rhysyim/Electronic-Speed-Controller/README.md

A hardware implementation using comparators to compare BEMF of motor in /PCB/Triple Half Bridge Driver v4b2. The original implementatoin with current sensing amplifier in /PCB/Triple Half Bridge Driver v4a (footprints not in place yet).
