rhysyim/Electronic-Speed-Controller/Code/Thermistor_Instrumentation/README.md

# Address Pin Connections

| Pin | Connection |
| --- | --- |
| GND | 0x48 |
| VDD | 0x49 |
| SDA | 0x4A |
| SCL | 0x4B |
