rhysyim/Electronic-Speed-Controller/Oscilloscope Traces/Nov 2024/Separated Ground Plane.bmp

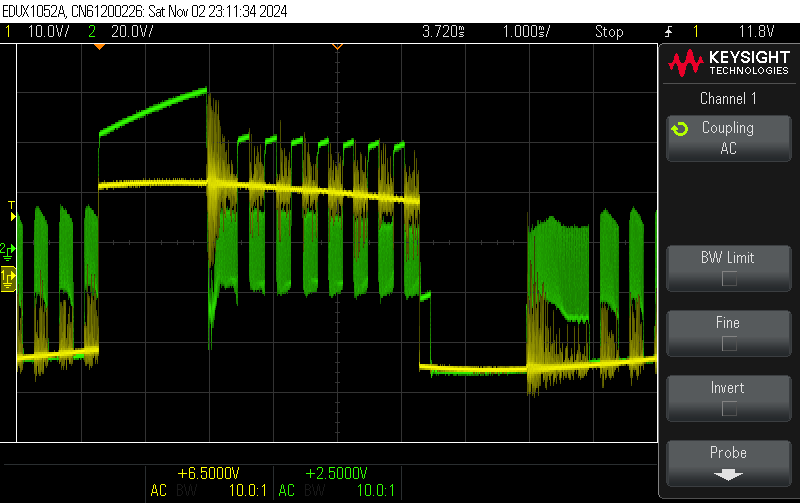
Oscilloscope Traces/Nov 2024/Separated Ground Plane.bmp
