rhysyim/Electronic-Speed-Controller/Oscilloscope Traces/Nov 2025/Gate driver output.png

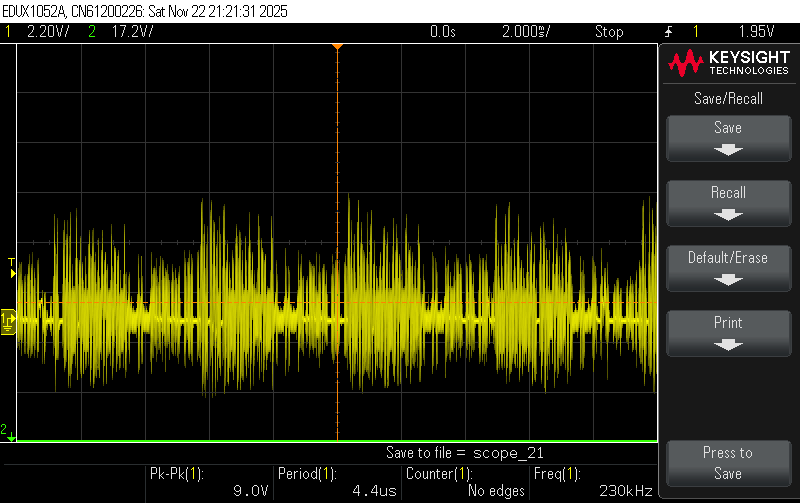
Oscilloscope Traces/Nov 2025/Gate driver output.png
