rhysyim/Electronic-Speed-Controller/Oscilloscope Traces/Nov 2025/Motor output (without turning).png

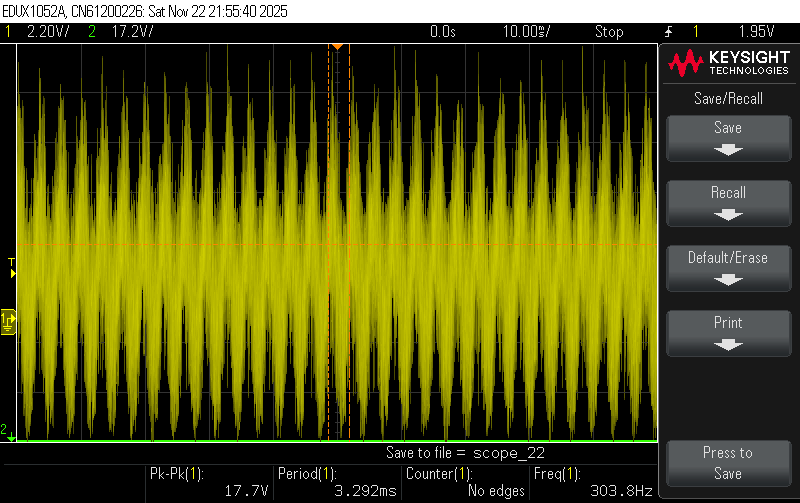
Oscilloscope Traces/Nov 2025/Motor output (without turning).png
