rhysyim/Electronic-Speed-Controller/Oscilloscope Traces/Nov 2025/PWM output from pi pico.png

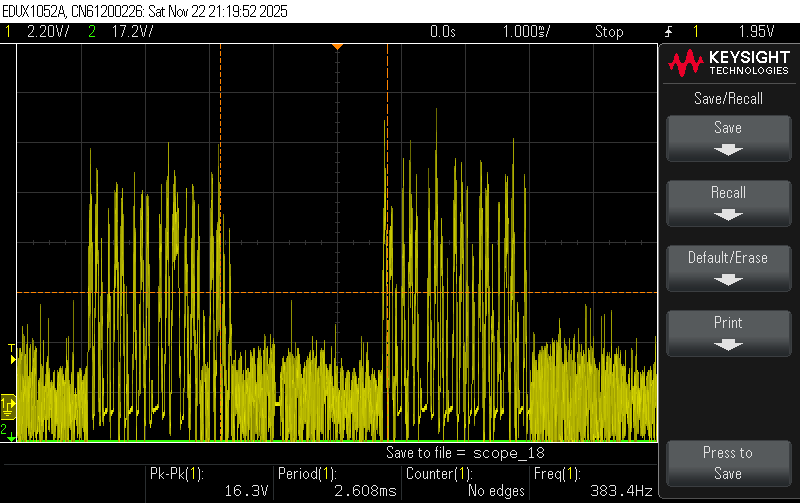
Oscilloscope Traces/Nov 2025/PWM output from pi pico.png
