rhysyim/Electronic-Speed-Controller/Bill of Materials Balancing Cube.docx

https://projecthub.arduino.cc/mircemk/arduino-3d-printed-self-balancing-cube-301832

MPU6050 for motion detection

Nidec 24h motors (?) or general BLDC motors
