rhysyim/Electronic-Speed-Controller/PCB/Triple Half Bridge Driver v4b3/PCB/ki-lime-pi-pico-1.0.0/models/RaspberryPi_Pico_Variations.FCStd

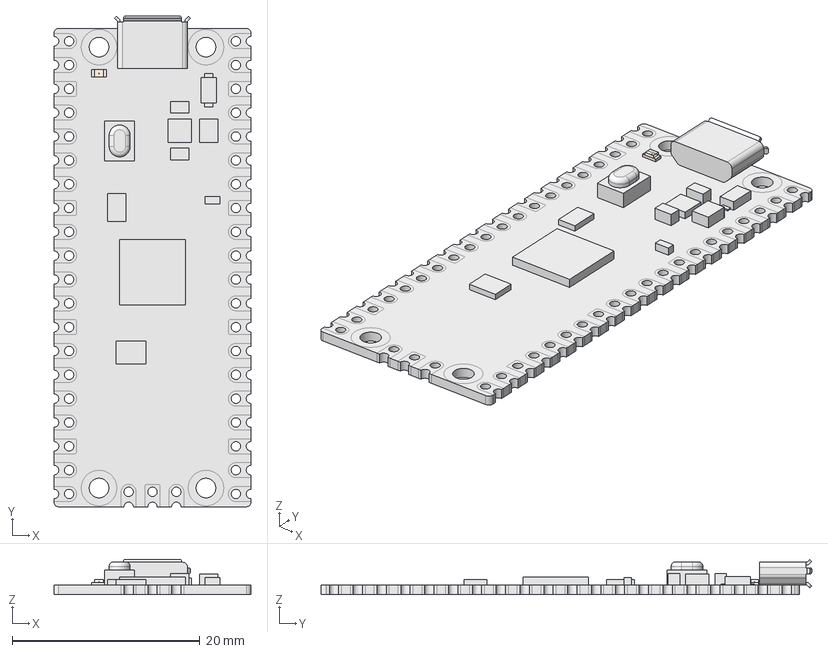
[picture p9: CAD file, 2026-09-11]
PCB/Triple Half Bridge Driver v4b3/PCB/ki-lime-pi-pico-1.0.0/models/RaspberryPi_Pico_Variations.FCStd
21.0 x 52.3 x 3.75 mm
Pico_Board
C1_47u
C2_47u
D1_MBR120VLSFT1G
D2_QSME-C194_Base
D2_QSME-C194_Phosphor
D2_QSME-C194_Lens
J1_690T505-x62-01x
L1_2u2
Q1_DMG1012T
SW1_TP-1221U-K9K5325
U1_RP2040
U2_RT6150B-33GQW
U3_W25Q16JVUXIQ
X1_X12M000000S096
