rhysyim/Electronic-Speed-Controller/Schematics_Annotated.pdf

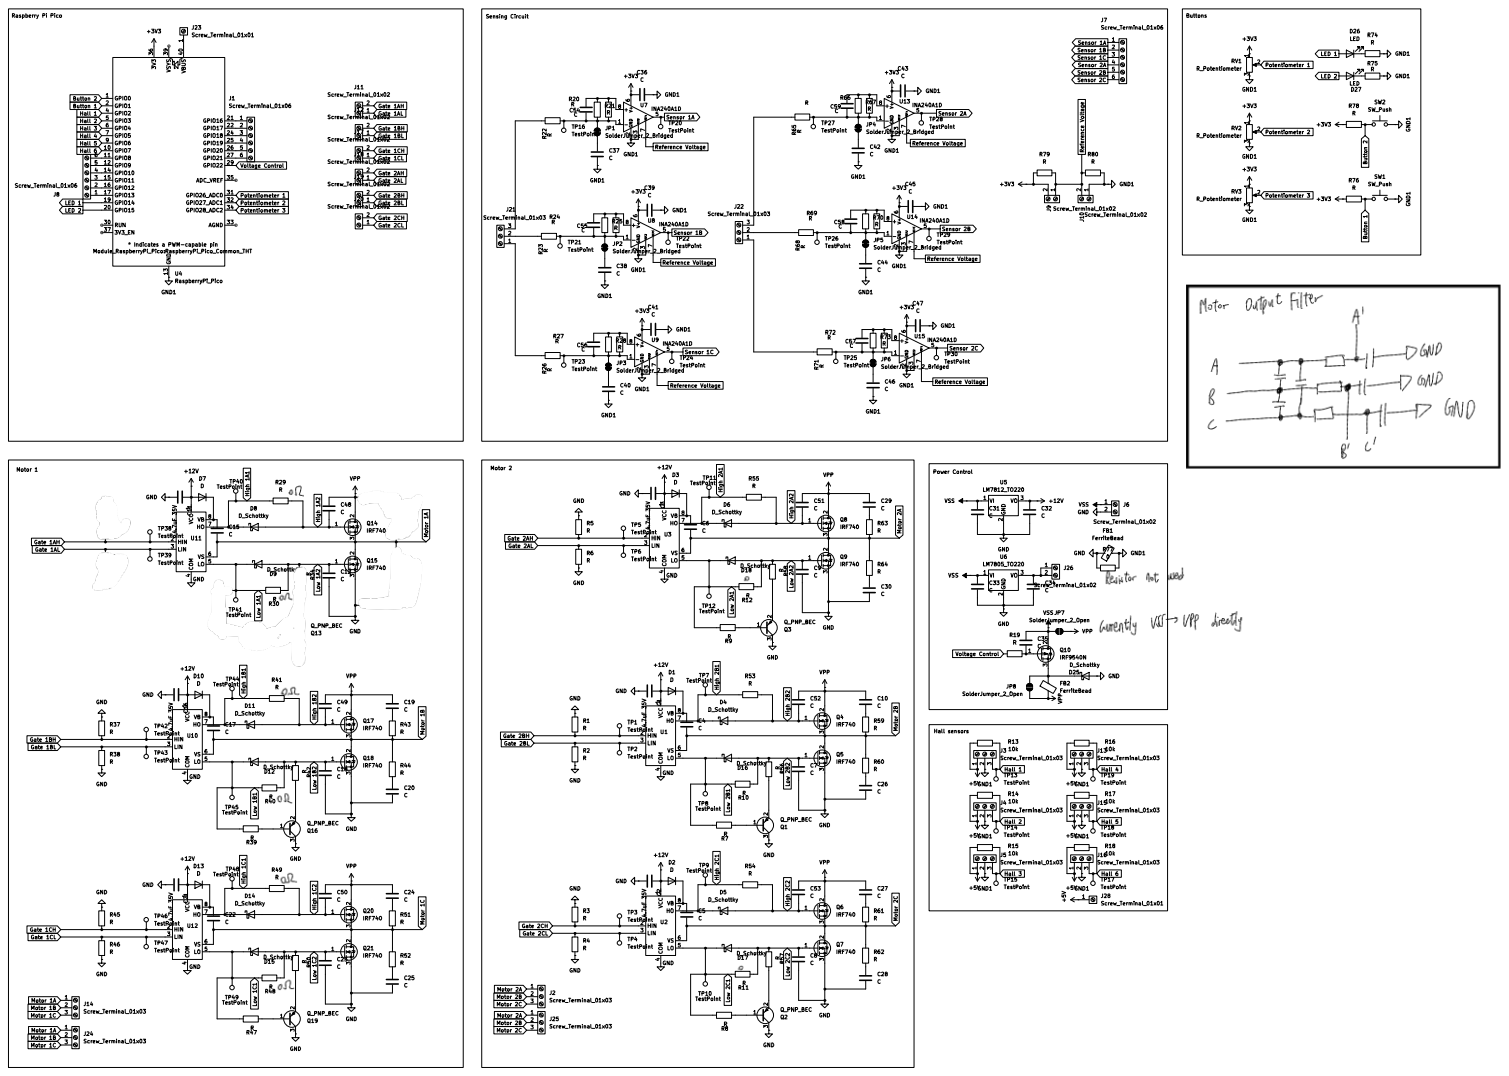
[picture p10: page 1]
