rhysyim/Electronic-Speed-Controller/Schematics.pdf

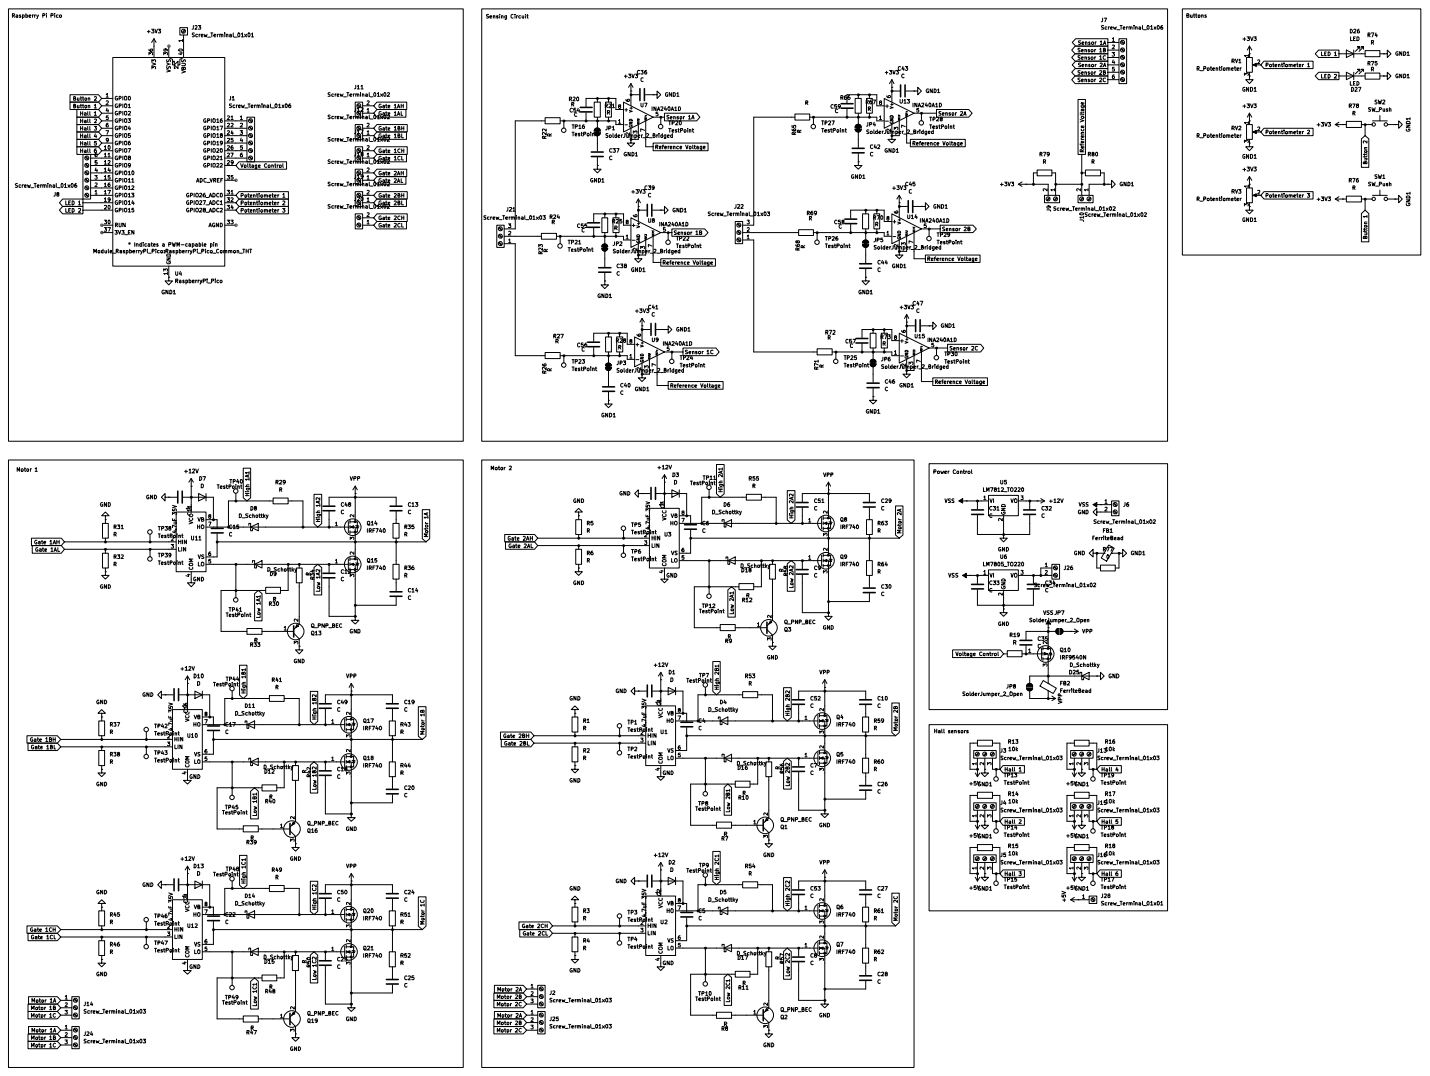
[picture p11: page 1]
