rhysyim/Electronic-Speed-Controller/PCB/Schematics Annotated.pdf

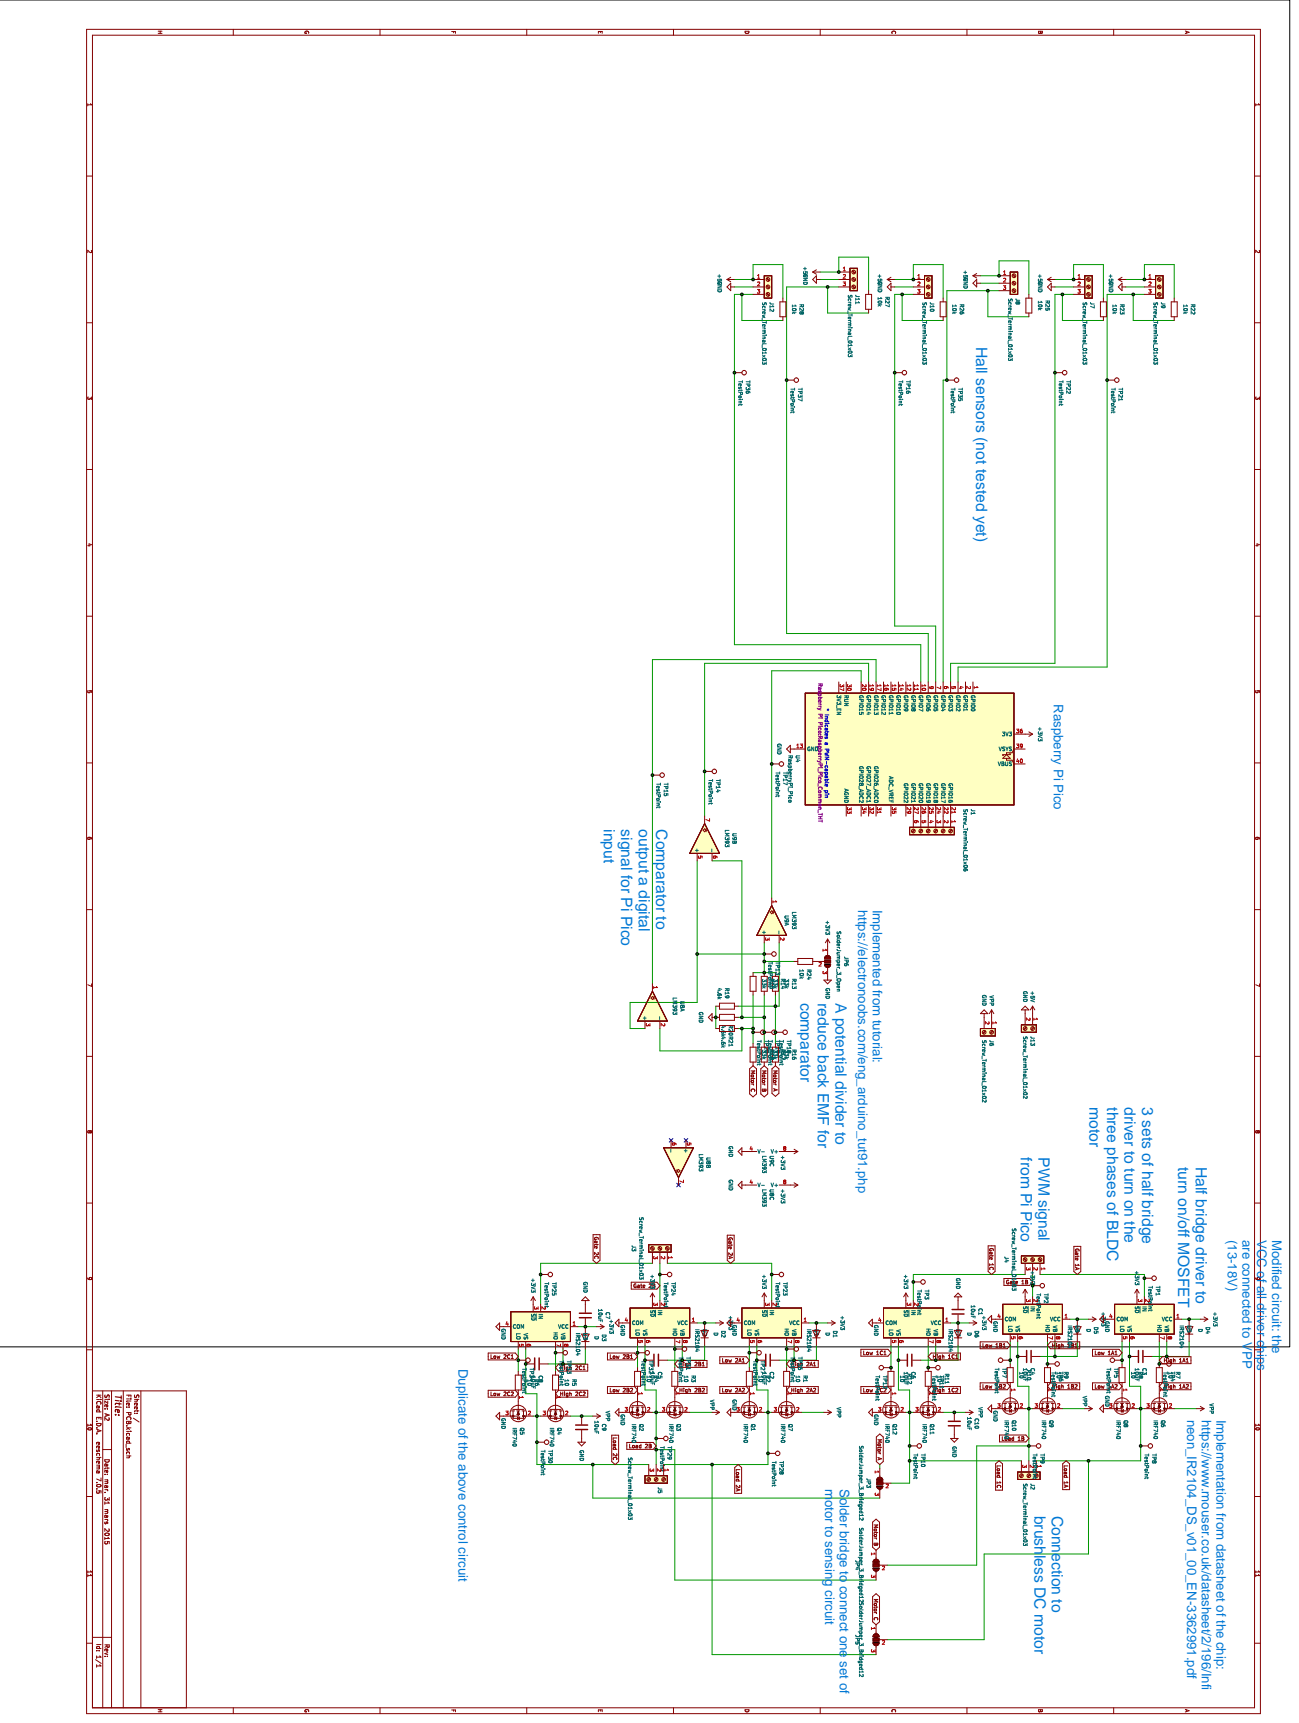
[picture p12: page 1]
