rhysyim/Electronic-Speed-Controller/PCB/Schematics.pdf

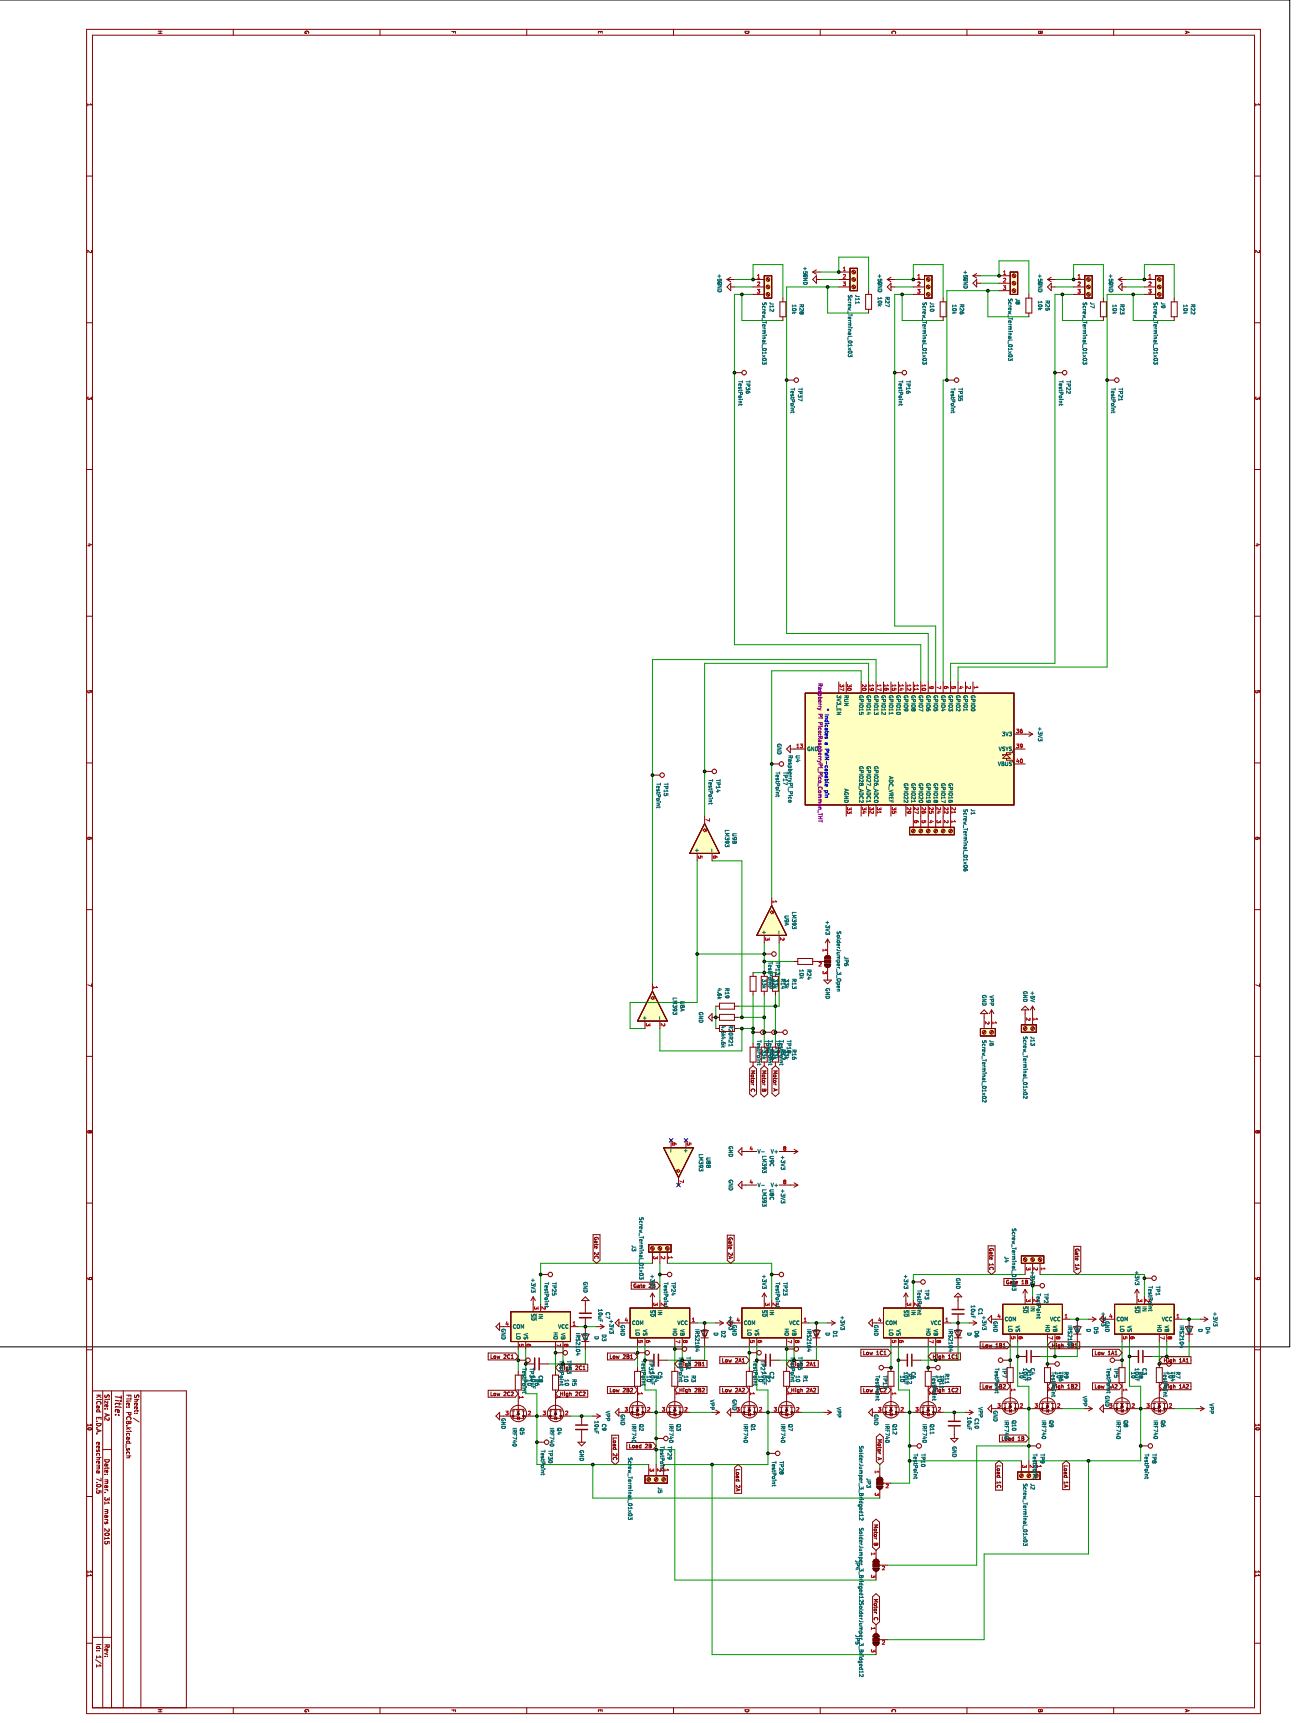
[picture p13: page 1]
