rhysyim/Electronic-Speed-Controller/PCB 2.pdf

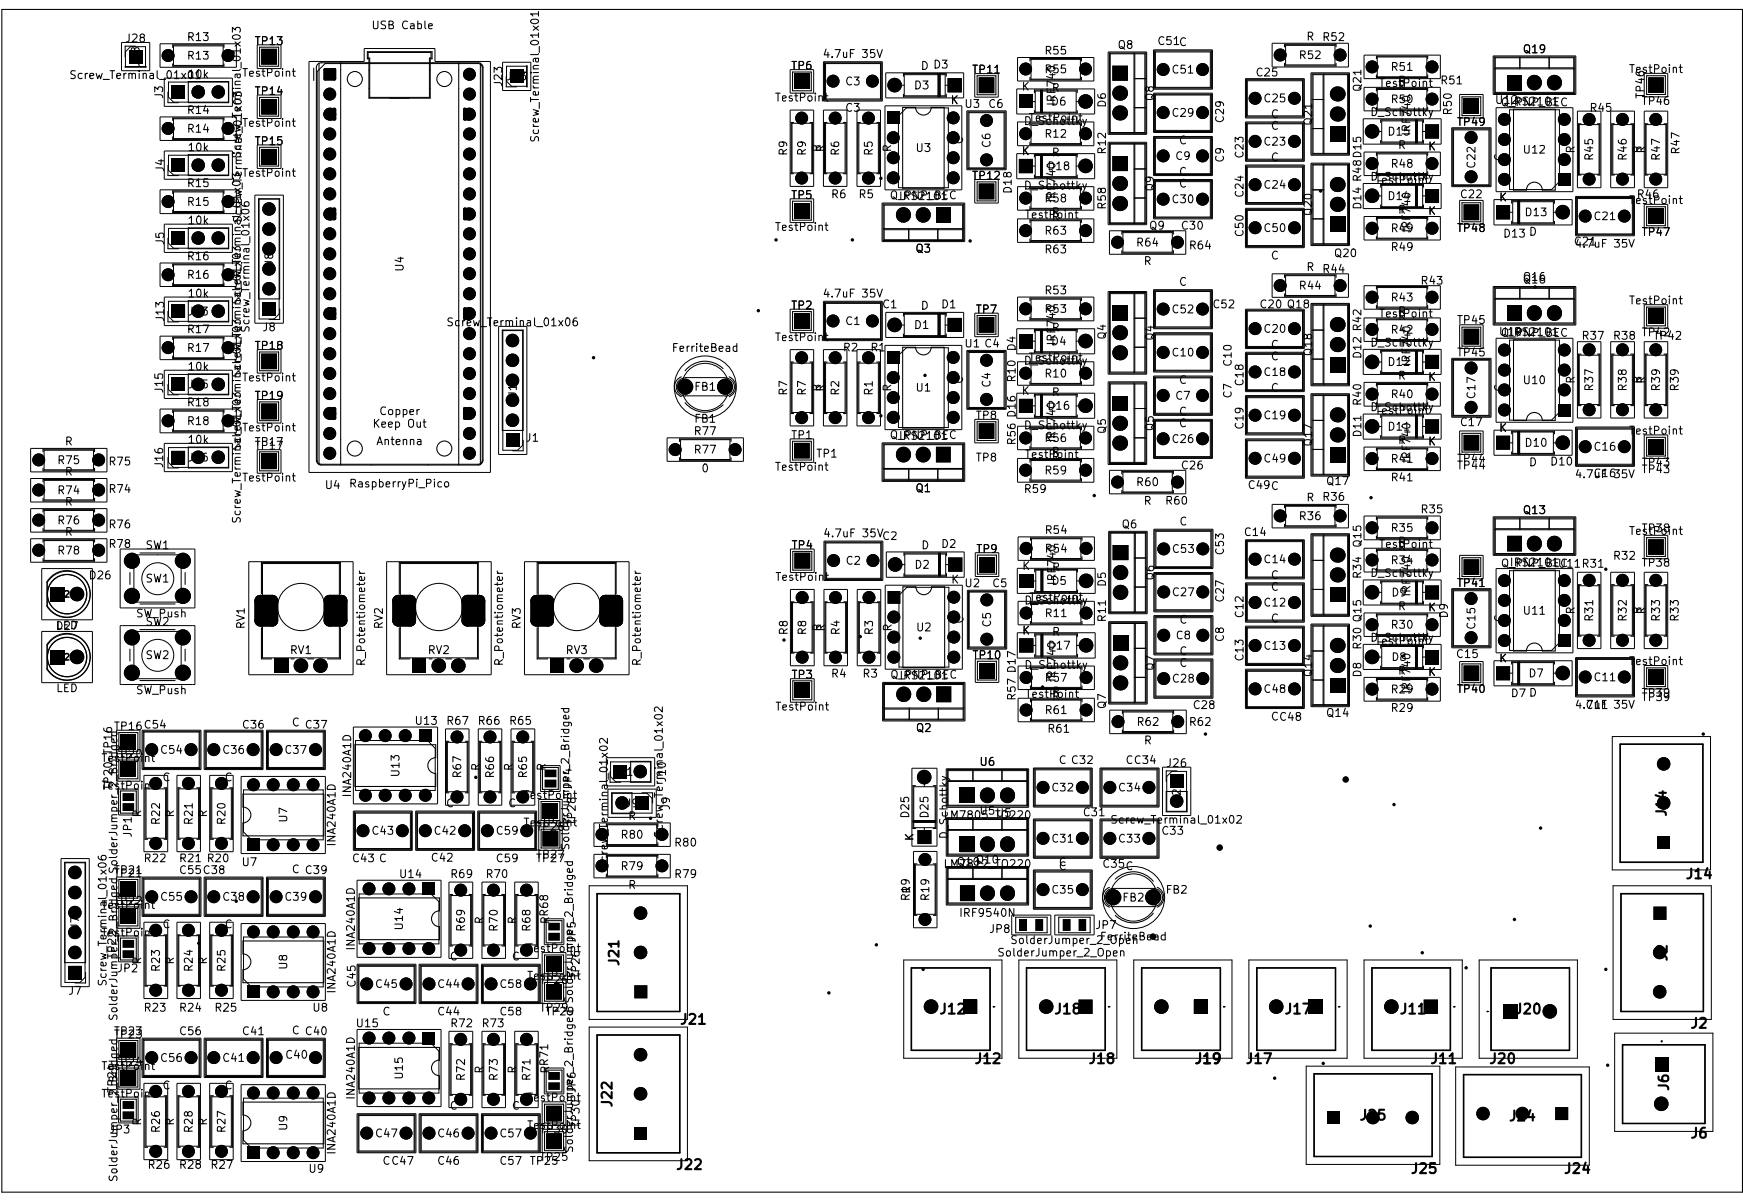
[picture p14: page 1]
