rhysyim/Electronic-Speed-Controller/(list of files, drawings)

Other design files:
PCB/Triple Half Bridge Driver v4b3/PCB.dsn
PCB/Triple Half Bridge Driver v4b4/PCB.dsn
