rhysyim/Electronic-Speed-Controller/PCB/Triple Half Bridge Driver v4b3/PCB/PCB.kicad_pcb

## KiCad design PCB/Triple Half Bridge Driver v4b3/PCB/PCB.kicad_pcb (2026-09-11)

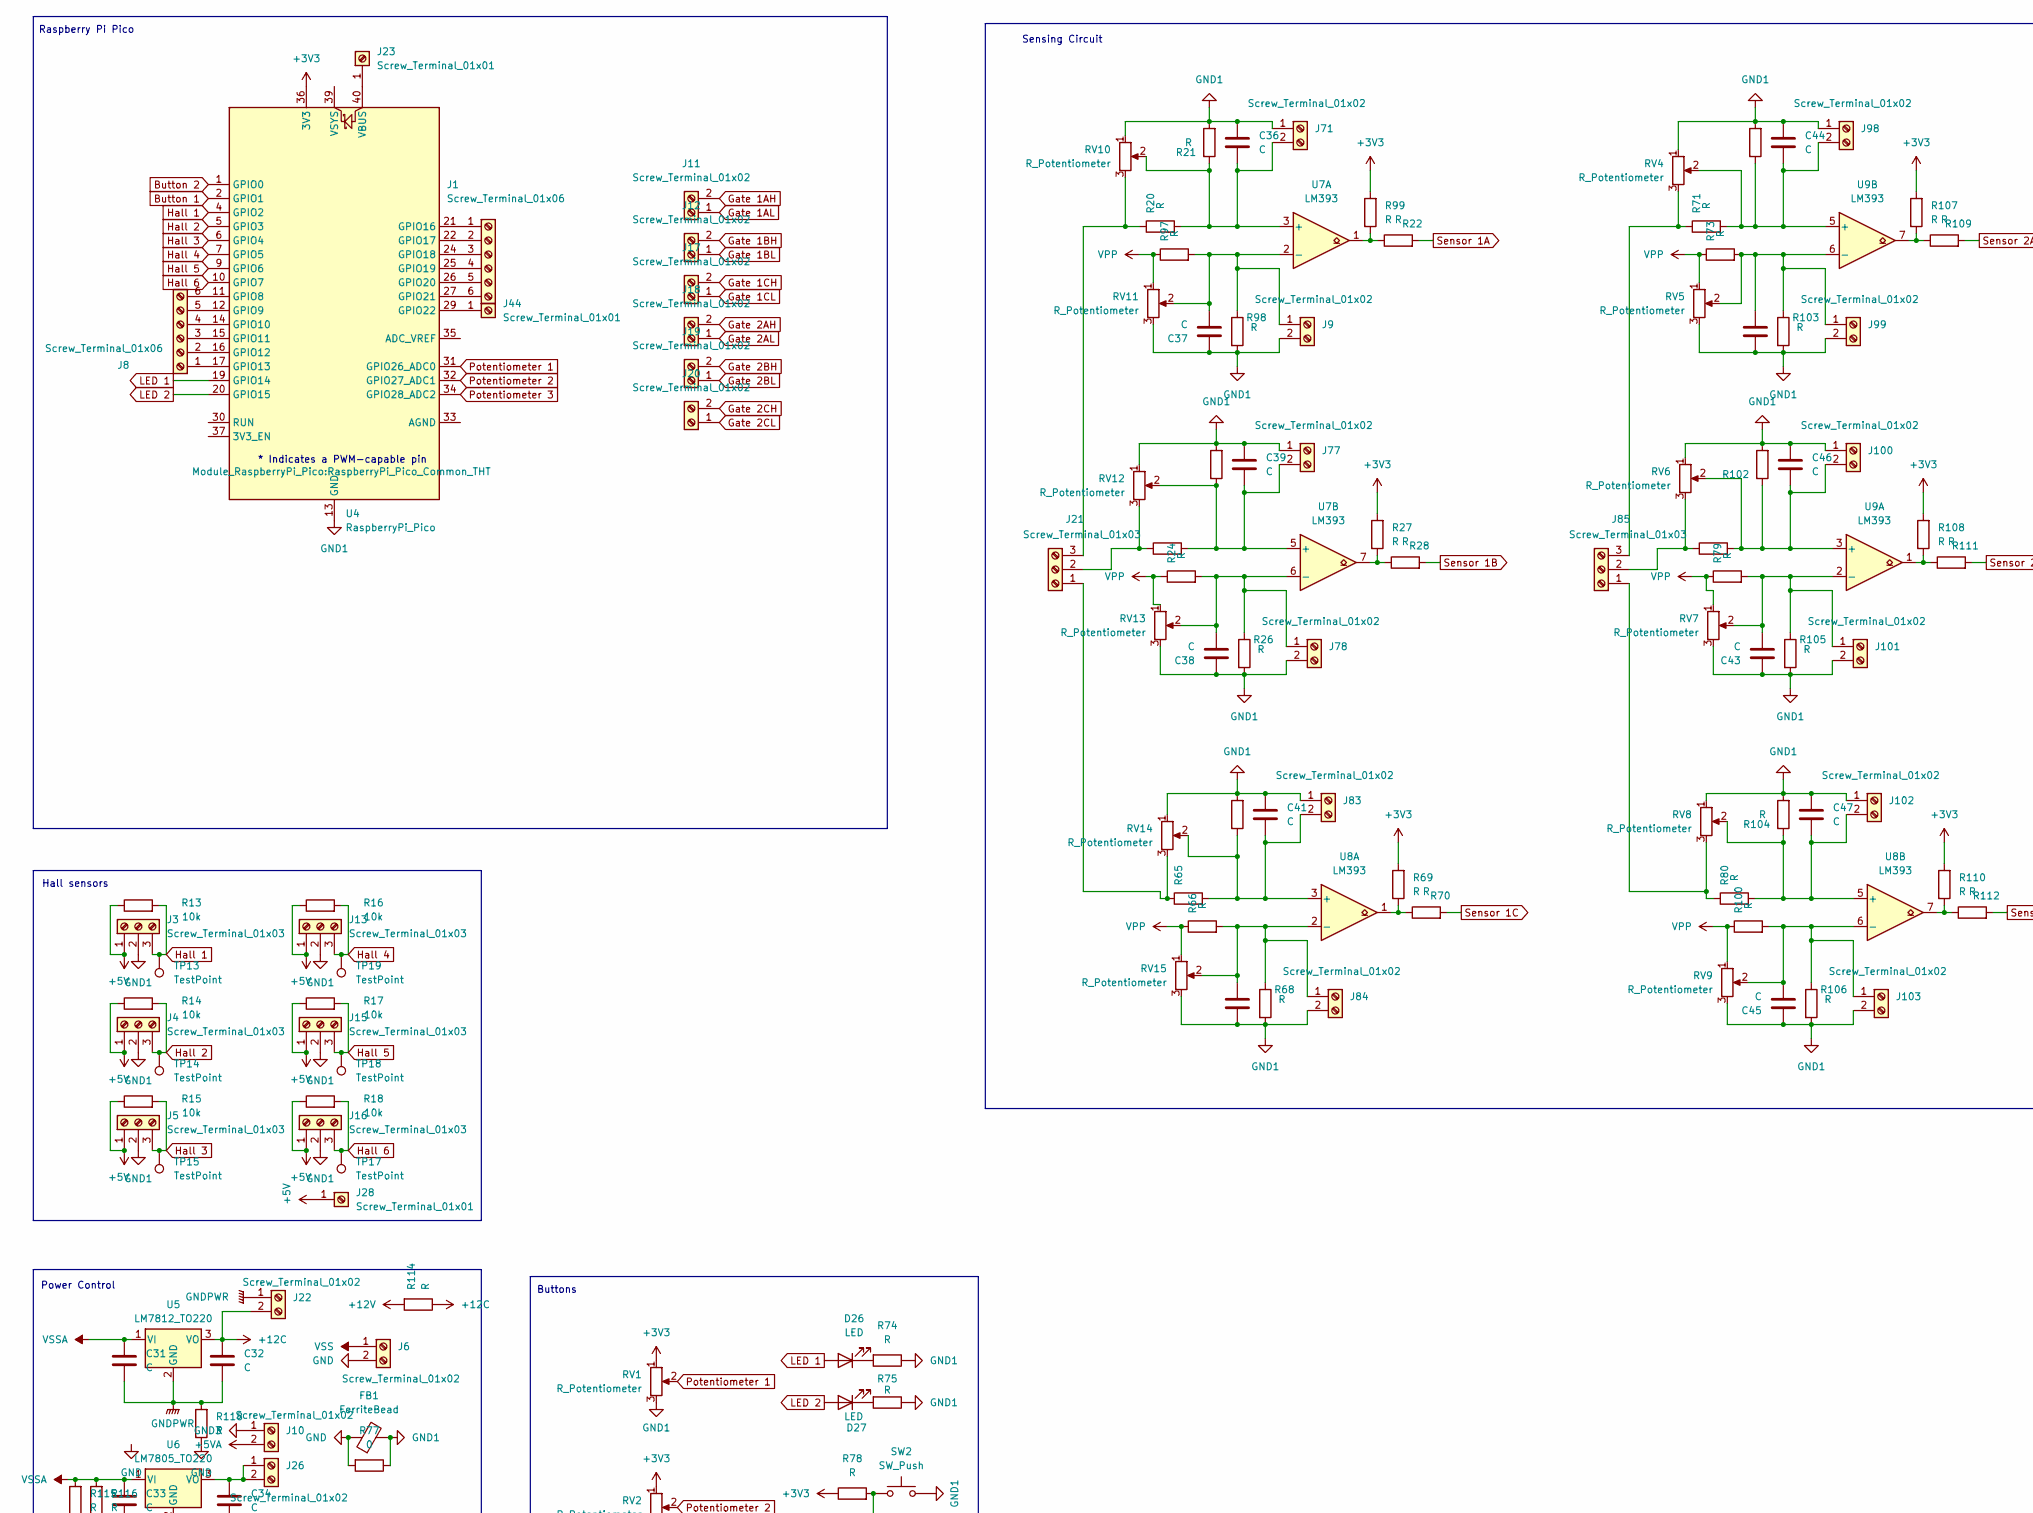
[picture p15: schematic PCB.kicad_sch, part in row 1, column 1]

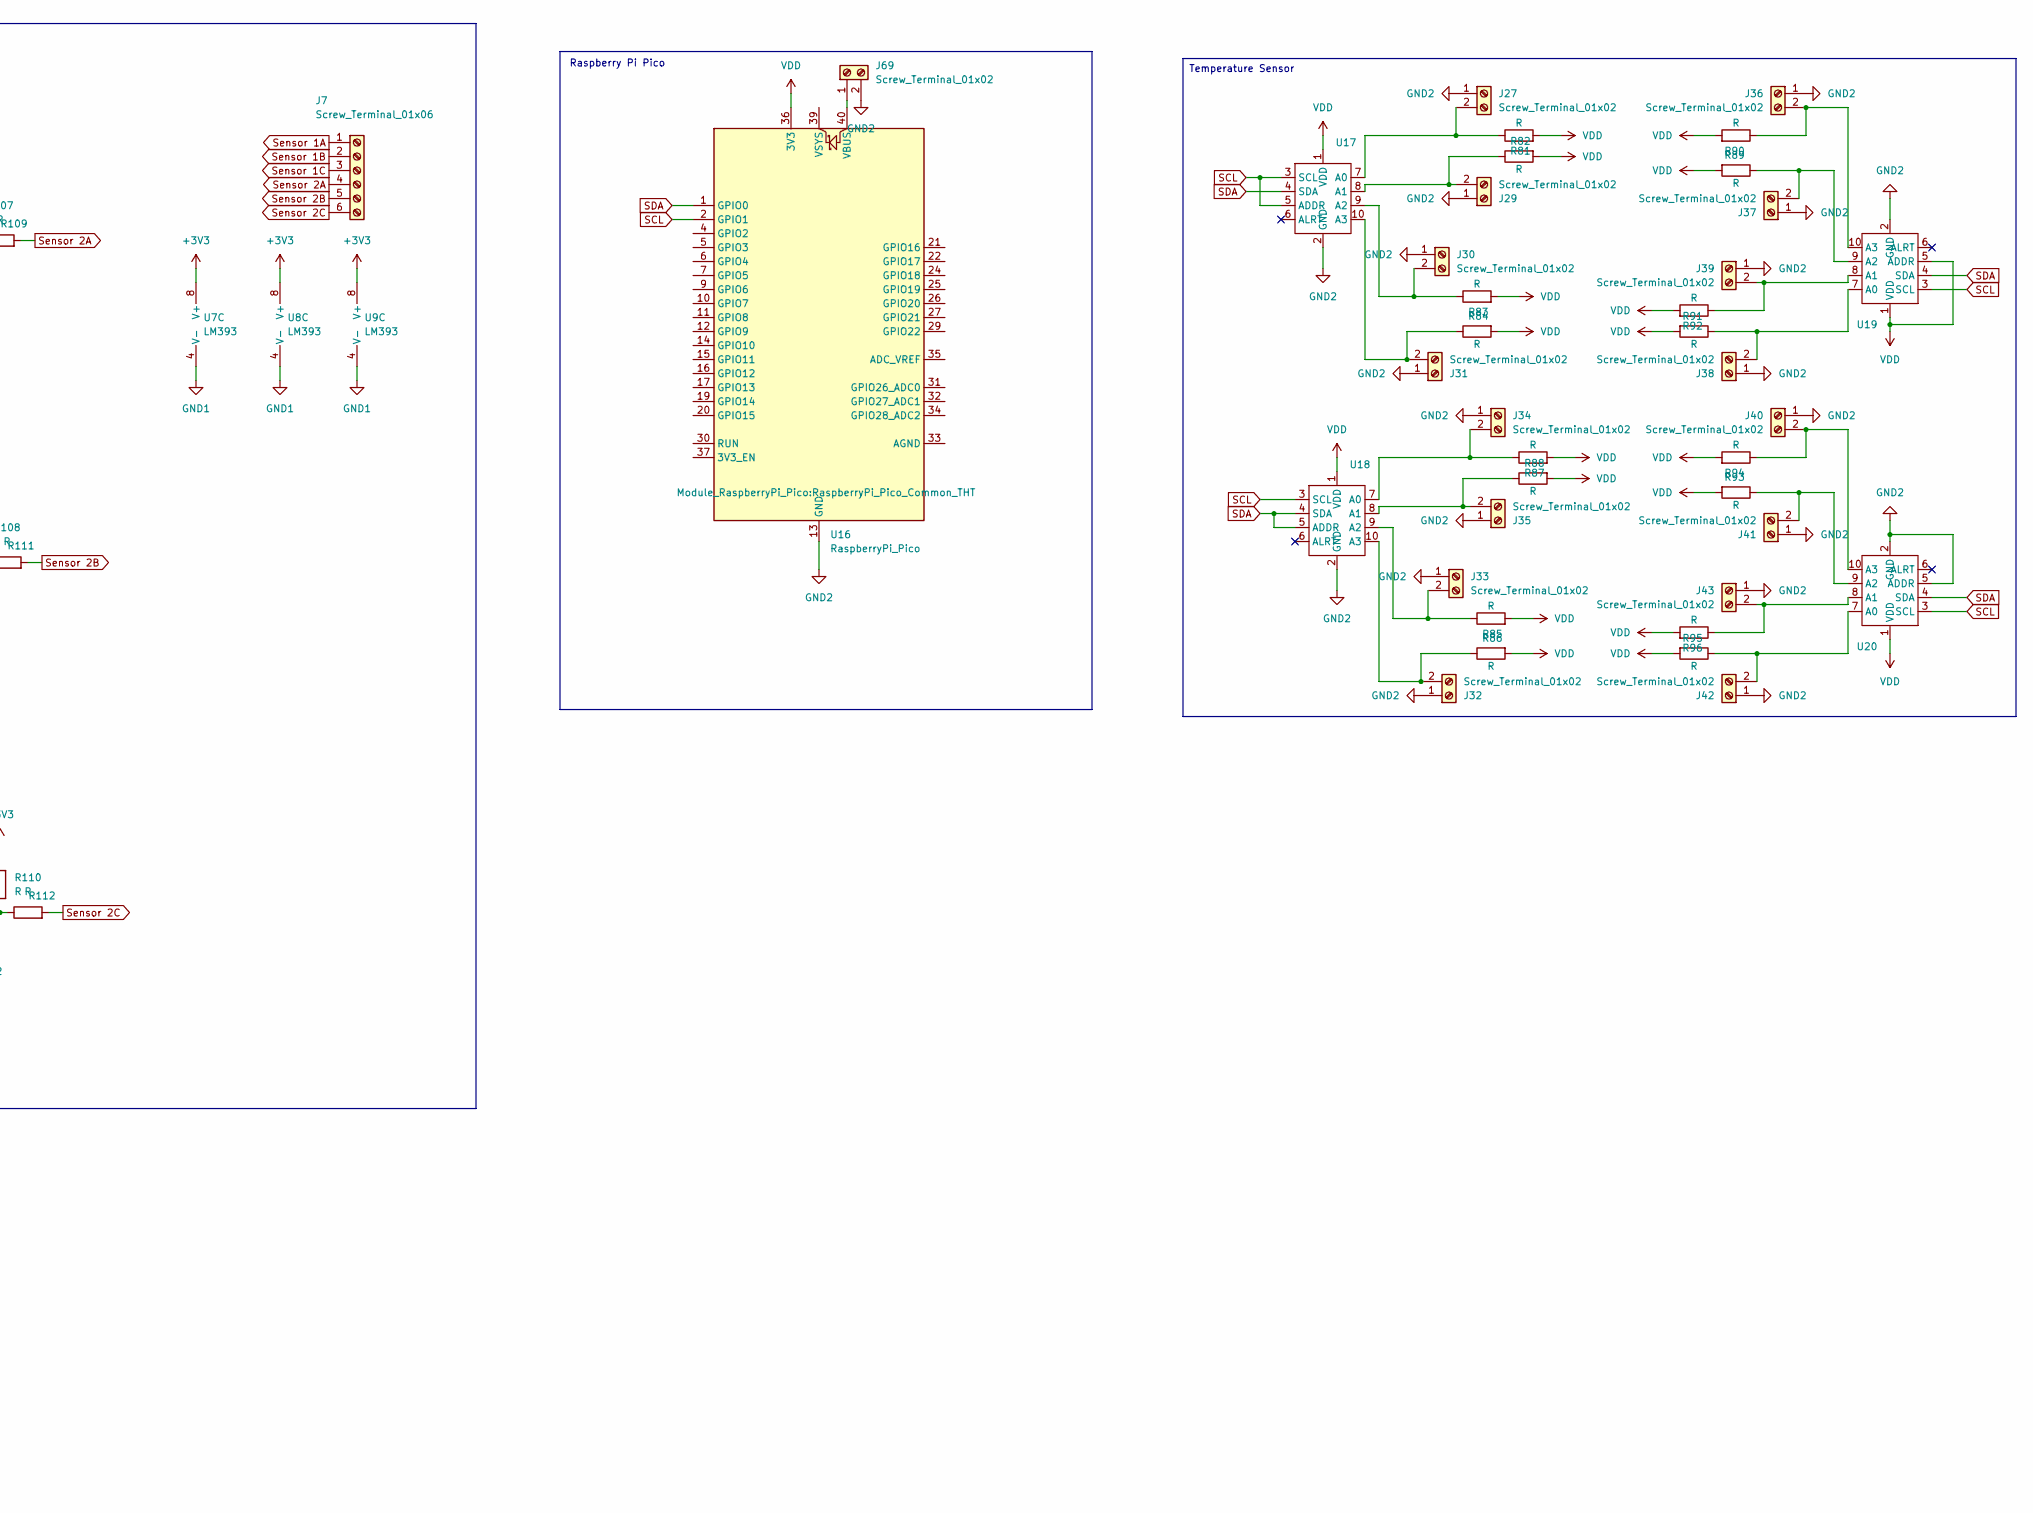
[picture p16: schematic PCB.kicad_sch, part in row 1, column 2]

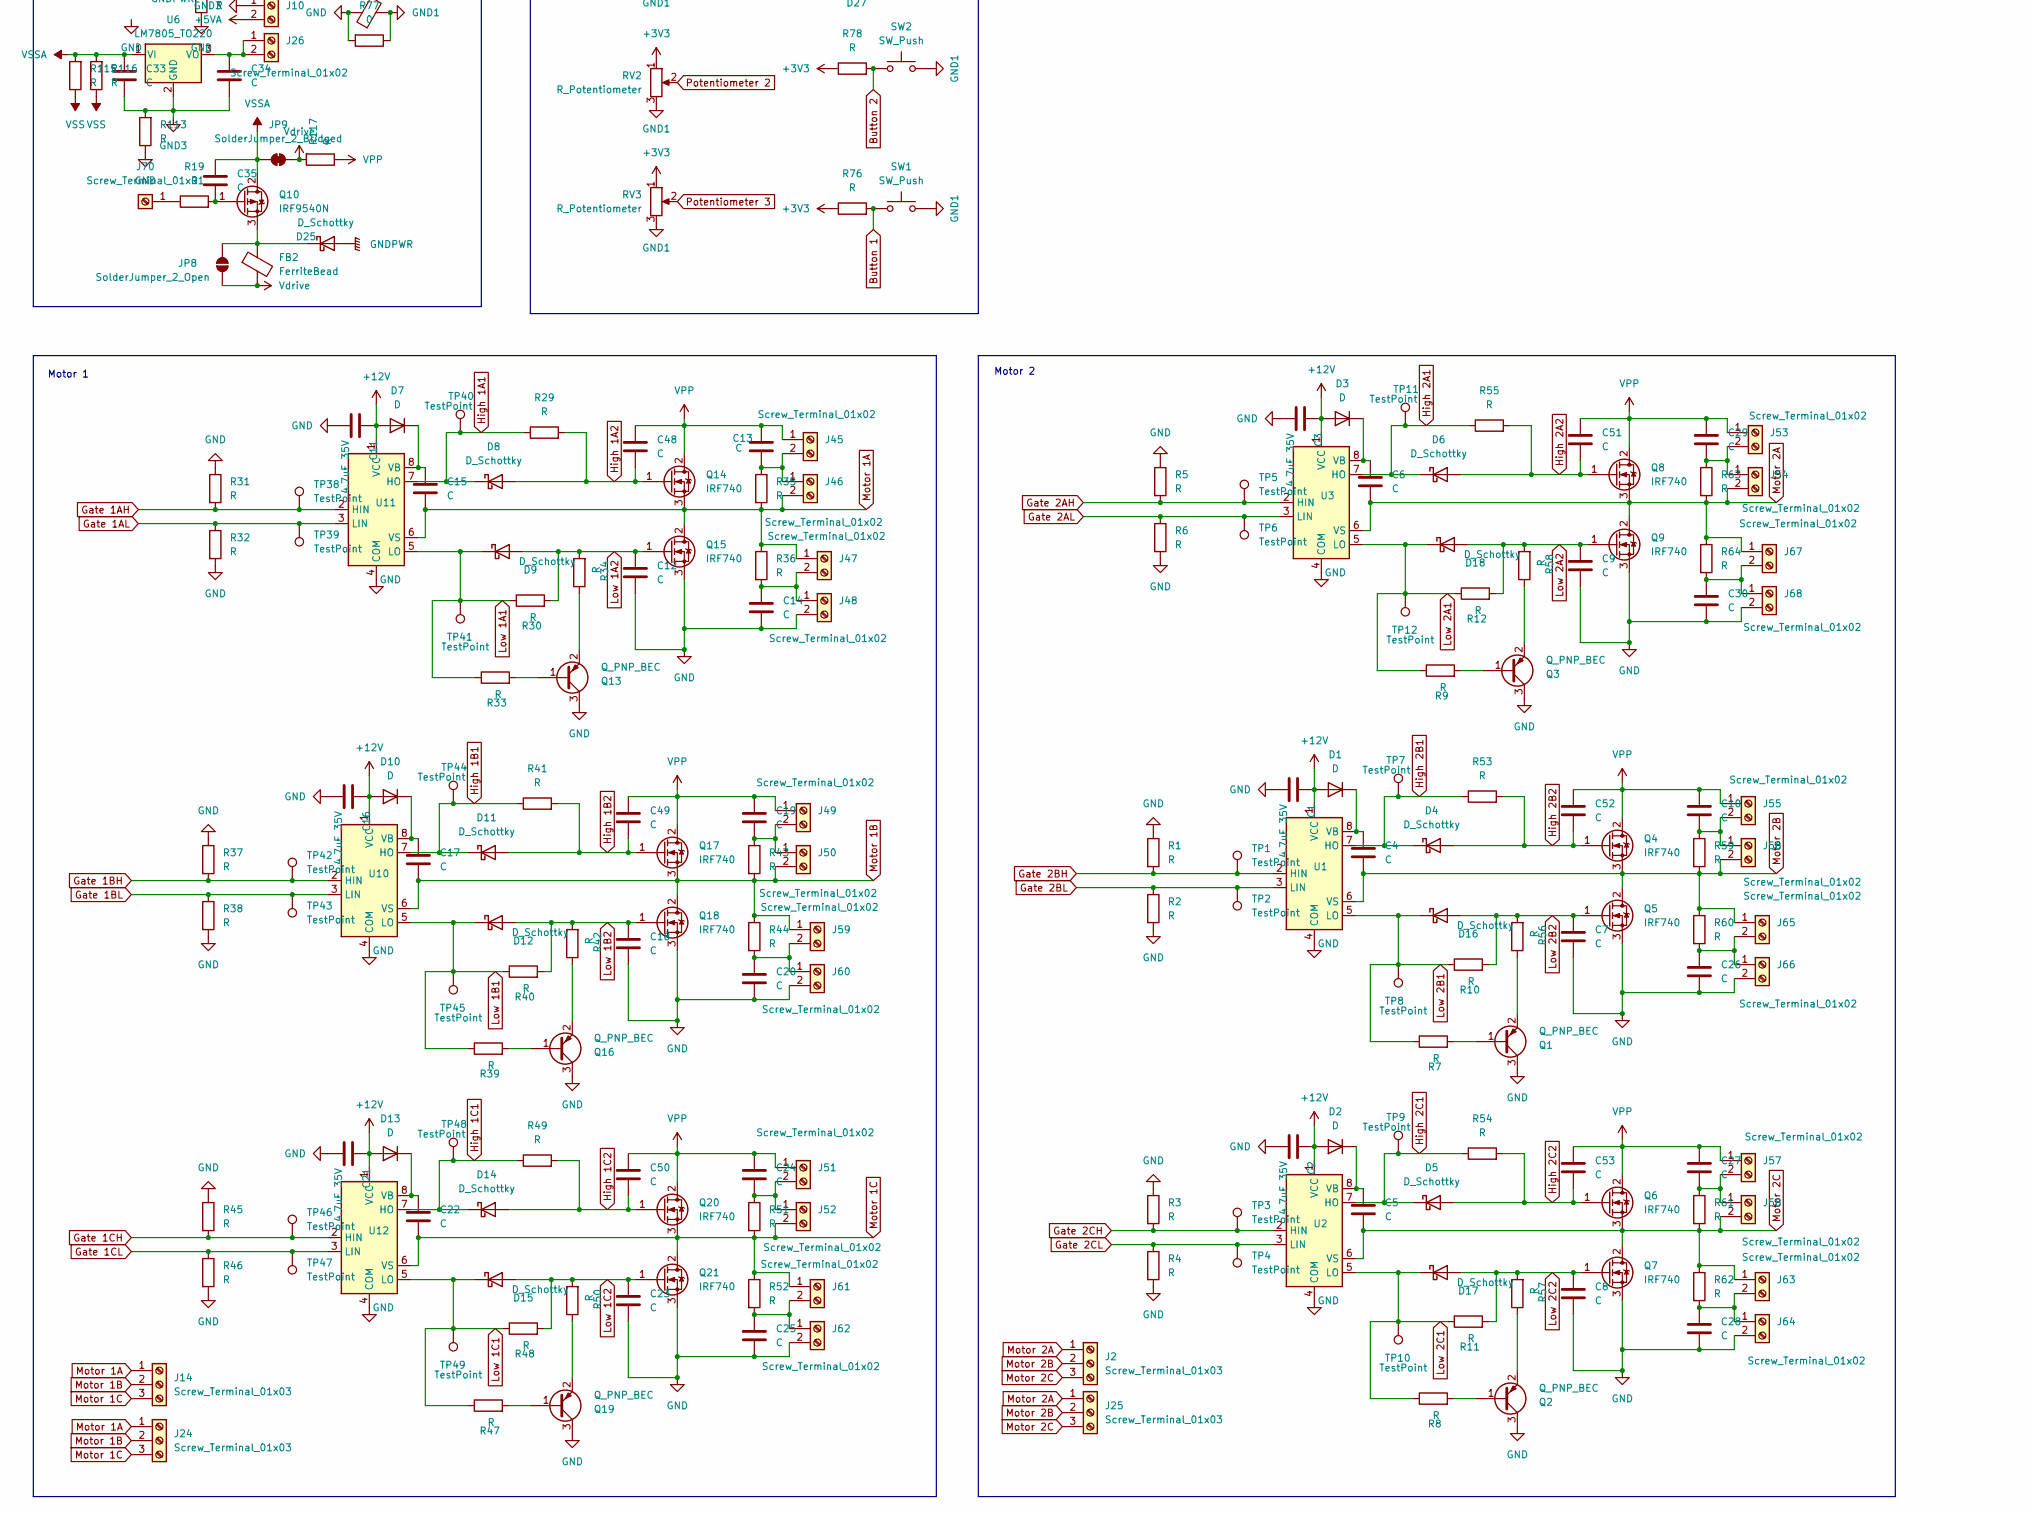
[picture p17: schematic PCB.kicad_sch, part in row 2, column 1]

Parts:
C1, C2, C3, C11, C16, C21: 4.7uF 35V; C_Rect_L7.0mm_W4.5mm_P5.00mm; LCSC C162274
C4, C5, C6, C7, C8, C9, C10, C12, C13, C14, C15, C17, C18, C19, C20, C22, C23, C24, C25, C26, C27, C28, C29, C30, C31, C32, C33, C34, C35, C36, C37, C38, C39, C40, C41, C42, C43, C44, C45, C46, C47, C48, C49, C50, C51, C52, C53: C; C_Rect_L7.0mm_W4.5mm_P5.00mm
D1, D2, D3, D7, D10, D13: D; D_A-405_P7.62mm_Horizontal
D4, D5, D6, D8, D9, D11, D12, D14, D15, D16, D17, D18, D25: D_Schottky; D_A-405_P7.62mm_Horizontal
D26, D27: LED; LED_D5.0mm
FB1, FB2: FerriteBead; LairdTech_28C0236-0JW-10
J1, J7, J8: Screw_Terminal_01x06; PinHeader_1x06_P2.54mm_Vertical
J2, J14, J21, J24, J25, J85: Screw_Terminal_01x03; 1792876
J3, J4, J5, J13, J15, J16: Screw_Terminal_01x03; PinHeader_1x03_P2.54mm_Vertical
J6, J9, J10, J11, J12, J17, J18, J19, J20, J22, J69: Screw_Terminal_01x02; 1792863
J23, J44, J70: Screw_Terminal_01x01; PinHeader_1x01_P2.54mm_Vertical
J26: Screw_Terminal_01x02; PinHeader_1x02_P2.54mm_Vertical
J27, J29, J30, J31, J32, J33, J34, J35, J36, J37, J38, J39, J40, J41, J42, J43, J45, J46, J47, J48, J49, J50, J51, J52, J53, J54, J55, J56, J57, J58, J59, J60, J61, J62, J63, J64, J65, J66, J67, J68, J71, J77, J78, J83, J84, J98, J99, J100, J101, J102, J103: Screw_Terminal_01x02; TerminalBlock_4Ucon_1x02_P3.50mm_Horizontal
J28: Screw_Terminal_01x01; TerminalBlock_4Ucon_1x02_P3.50mm_Horizontal
JP8: SolderJumper_2_Open; SolderJumper-2_P1.3mm_Open_Pad1.0x1.5mm
JP9: SolderJumper_2_Bridged; SolderJumper-2_P1.3mm_Bridged_Pad1.0x1.5mm
Q1, Q2, Q3, Q13, Q16, Q19: Q_PNP_BEC; TO-220-3_Vertical; LCSC C686646
Q4, Q5, Q6, Q7, Q8, Q9, Q14, Q15, Q17, Q18, Q20, Q21: IRF740; TO-220-3_Vertical
Q10: IRF9540N; TO-220-3_Vertical
R1, R2, R3, R4, R5, R6, R7, R8, R9, R10, R11, R12, R19, R20, R21, R22, R23, R24, R25, R26, R27, R28, R29, R30, R31, R32, R33, R34, R35, R36, R37, R38, R39, R40, R41, R42, R43, R44, R45, R46, R47, R48, R49, R50, R51, R52, R53, R54, R55, R56, R57, R58, R59, R60, R61, R62, R63, R64, R65, R66, R67, R68, R69, R70, R71, R72, R73, R74, R75, R76, R78, R79, R80, R81, R82, R83, R84, R85, R86, R87, R88, R89, R90, R91, R92, R93, R94, R95, R96, R97, R98, R99, R100, R101, R102, R103, R104, R105, R106, R107, R108, R109, R110, R111, R112, R113, R114, R115, R116, R117, R118: R; R_Axial_DIN0207_L6.3mm_D2.5mm_P7.62mm_Horizontal
R13, R14, R15, R16, R17, R18: 10k; R_Axial_DIN0207_L6.3mm_D2.5mm_P7.62mm_Horizontal
R77: 0; R_Axial_DIN0207_L6.3mm_D2.5mm_P7.62mm_Horizontal
RV1, RV2, RV3, RV4, RV5, RV6, RV7, RV8, RV9, RV10, RV11, RV12, RV13, RV14, RV15: R_Potentiometer; Potentiometer_Alps_RK09K_Single_Vertical
SW1, SW2: SW_Push; SW_PUSH_6mm_H8.5mm
TP1, TP2, TP3, TP4, TP5, TP6, TP7, TP8, TP9, TP10, TP11, TP12, TP13, TP14, TP15, TP17, TP18, TP19, TP38, TP39, TP40, TP41, TP42, TP43, TP44, TP45, TP46, TP47, TP48, TP49: TestPoint; TestPoint_THTPad_2.0x2.0mm_Drill1.0mm
U1, U2, U3, U10, U11, U12: IRS2101; DIP-8_W7.62mm
U4, U16: RaspberryPi_Pico; RaspberryPi_Pico_Common_THT
U5: LM7812_TO220; TO-220-3_Vertical
U6: LM7805_TO220; TO-220-3_Vertical
U7, U8, U9: LM393; DIP-8_W7.62mm
U17, U18, U19, U20: Adafruit_ADS1115

Connections:
+3V3: R27.2, R69.2, R76.1, R78.1, R99.2, R107.2, R108.2, R110.2, RV1.1, RV2.1, RV3.1, U4.36 (3V3), U7.8 (V+), U8.8 (V+), U9.8 (V+)
+5V: J3.1, J4.1, J5.1, J13.1, J15.1, J16.1, J28.1, R13.1, R14.1, R15.1, R16.1, R17.1, R18.1
+5VA: J10.2
+12C: C32.1, J22.2, R114.1, U5.3 (VO)
+12V: C1.1, C2.1, C3.1, C11.1, C16.1, C21.1, D1.2 (A), D2.2 (A), D3.2 (A), D7.2 (A), D10.2 (A), D13.2 (A), R114.2, U1.1 (VCC), U2.1 (VCC), U3.1 (VCC), U10.1 (VCC), U11.1 (VCC), U12.1 (VCC)
Button 1: R76.2, SW1.1, U4.2 (GPIO1)
Button 2: R78.2, SW2.1, U4.1 (GPIO0)
GND: C1.2, C2.2, C3.2, C7.2, C8.2, C9.2, C11.2, C12.2, C14.2, C16.2, C18.2, C20.2, C21.2, C23.2, C25.2, C26.2, C28.2, C30.2, FB1.1, J6.2, J48.2, J60.2, J62.2, J64.2, J66.2, J68.2, Q1.3 (C), Q2.3 (C), Q3.3 (C), Q5.3 (S), Q7.3 (S), Q9.3 (S), Q13.3 (C), Q15.3 (S), Q16.3 (C), Q18.3 (S), Q19.3 (C), Q21.3 (S), R1.1, R2.2, R3.1, R4.2, R5.1, R6.2, R31.1, R32.2, R37.1, R38.2, R45.1, R46.2, R77.2, R113.1, R118.1, U1.4 (COM), U2.4 (COM), U3.4 (COM), U10.4 (COM), U11.4 (COM), U12.4 (COM)
GND1: C36.1, C37.1, C38.1, C39.1, C40.1, C41.1, C42.1, C43.1, C44.1, C45.1, C46.1, C47.1, FB1.2, J3.2, J4.2, J5.2, J9.2, J13.2, J15.2, J16.2, J71.1, J77.1, J78.2, J83.1, J84.2, J98.1, J99.2, J100.1, J101.2, J102.1, J103.2, R21.2, R25.2, R26.2, R67.2, R68.2, R74.1, R75.1, R77.1, R98.2, R101.2, R102.2, R103.2, R104.2, R105.2, R106.2, RV1.3, RV2.3, RV3.3, RV4.1, RV5.3, RV6.1, RV7.3, RV8.1, RV9.3, RV10.1, RV11.3, RV12.1, RV13.3, RV14.1, RV15.3, SW1.2, SW2.2, U4.3 (GND), U4.8 (GND), U4.13 (GND), U4.18 (GND), U4.23 (GND), U4.28 (GND), U4.38 (GND), U7.4 (V-), U8.4 (V-), U9.4 (V-)
GND2: J27.1, J29.1, J30.1, J31.1, J32.1, J33.1, J34.1, J35.1, J36.1, J37.1, J38.1, J39.1, J40.1, J41.1, J42.1, J43.1, J69.2, U16.3 (GND), U16.8 (GND), U16.13 (GND), U16.18 (GND), U16.23 (GND), U16.28 (GND), U16.38 (GND), U17.2 (GND), U18.2 (GND), U19.2 (GND), U20.2 (GND), U20.5 (ADDR)
GND3: C33.2, C34.2, J10.1, R113.2, U6.2 (GND)
GNDPWR: C31.2, C32.2, D25.2 (A), J22.1, R118.2, U5.2 (GND)
Gate 1AH: J11.2, R31.2, TP38.1, U11.2 (HIN)
Gate 1AL: J11.1, R32.1, TP39.1, U11.3 (LIN)
Gate 1BH: J12.2, R37.2, TP42.1, U10.2 (HIN)
Gate 1BL: J12.1, R38.1, TP43.1, U10.3 (LIN)
Gate 1CH: J17.2, R45.2, TP46.1, U12.2 (HIN)
Gate 1CL: J17.1, R46.1, TP47.1, U12.3 (LIN)
Gate 2AH: J18.2, R5.2, TP5.1, U3.2 (HIN)
Gate 2AL: J18.1, R6.1, TP6.1, U3.3 (LIN)
Gate 2BH: J19.2, R1.2, TP1.1, U1.2 (HIN)
Gate 2BL: J19.1, R2.1, TP2.1, U1.3 (LIN)
Gate 2CH: J20.2, R3.2, TP3.1, U2.2 (HIN)
Gate 2CL: J20.1, R4.1, TP4.1, U2.3 (LIN)
Hall 1: J3.3, R13.2, TP13.1, U4.4 (GPIO2)
Hall 2: J4.3, R14.2, TP14.1, U4.5 (GPIO3)
Hall 3: J5.3, R15.2, TP15.1, U4.6 (GPIO4)
Hall 4: J13.3, R16.2, TP19.1, U4.7 (GPIO5)
Hall 5: J15.3, R17.2, TP18.1, U4.9 (GPIO6)
Hall 6: J16.3, R18.2, TP17.1, U4.10 (GPIO7)
High 1A1: D8.1 (K), R29.1, TP40.1, U11.7 (HO)
High 1A2: C48.2, D8.2 (A), Q14.1 (G), R29.2
High 1B1: D11.1 (K), R41.1, TP44.1, U10.7 (HO)
High 1B2: C49.2, D11.2 (A), Q17.1 (G), R41.2
High 1C1: D14.1 (K), R49.1, TP48.1, U12.7 (HO)
High 1C2: C50.2, D14.2 (A), Q20.1 (G), R49.2
High 2A1: D6.1 (K), R55.1, TP11.1, U3.7 (HO)
High 2A2: C51.2, D6.2 (A), Q8.1 (G), R55.2
High 2B1: D4.1 (K), R53.1, TP7.1, U1.7 (HO)
High 2B2: C52.2, D4.2 (A), Q4.1 (G), R53.2
High 2C1: D5.1 (K), R54.1, TP9.1, U2.7 (HO)
High 2C2: C53.2, D5.2 (A), Q6.1 (G), R54.2
LED 1: D26.2 (A), U4.19 (GPIO14)
LED 2: D27.2 (A), U4.20 (GPIO15)
Low 1A1: D9.1 (K), R30.1, R33.1, TP41.1, U11.5 (LO)
Low 1A2: C12.1, D9.2 (A), Q15.1 (G), R30.2, R34.2
Low 1B1: D12.1 (K), R39.1, R40.1, TP45.1, U10.5 (LO)
Low 1B2: C18.1, D12.2 (A), Q18.1 (G), R40.2, R42.2
Low 1C1: D15.1 (K), R47.1, R48.1, TP49.1, U12.5 (LO)
Low 1C2: C23.1, D15.2 (A), Q21.1 (G), R48.2, R50.2
Low 2A1: D18.1 (K), R9.1, R12.1, TP12.1, U3.5 (LO)
Low 2A2: C9.1, D18.2 (A), Q9.1 (G), R12.2, R58.2
Low 2B1: D16.1 (K), R7.1, R10.1, TP8.1, U1.5 (LO)
Low 2B2: C7.1, D16.2 (A), Q5.1 (G), R10.2, R56.2
Low 2C1: D17.1 (K), R8.1, R11.1, TP10.1, U2.5 (LO)
Low 2C2: C8.1, D17.2 (A), Q7.1 (G), R11.2, R57.2
Motor 1A: C15.2, J14.1, J24.1, J46.2, J47.1, Q14.3 (S), Q15.2 (D), R35.2, R36.1, U11.6 (VS)
Motor 1B: C17.2, J14.2, J24.2, J50.2, J59.1, Q17.3 (S), Q18.2 (D), R43.2, R44.1, U10.6 (VS)
Motor 1C: C22.2, J14.3, J24.3, J52.2, J61.1, Q20.3 (S), Q21.2 (D), R51.2, R52.1, U12.6 (VS)
Motor 2A: C6.2, J2.1, J25.1, J54.2, J67.1, Q8.3 (S), Q9.2 (D), R63.2, R64.1, U3.6 (VS)
Motor 2B: C4.2, J2.2, J25.2, J56.2, J65.1, Q4.3 (S), Q5.2 (D), R59.2, R60.1, U1.6 (VS)
Motor 2C: C5.2, J2.3, J25.3, J58.2, J63.1, Q6.3 (S), Q7.2 (D), R61.2, R62.1, U2.6 (VS)
unnamed: C4.1, D1.1 (K), U1.8 (VB)
unnamed: C5.1, D2.1 (K), U2.8 (VB)
unnamed: C6.1, D3.1 (K), U3.8 (VB)
unnamed: C15.1, D7.1 (K), U11.8 (VB)
unnamed: C17.1, D10.1 (K), U10.8 (VB)
unnamed: C22.1, D13.1 (K), U12.8 (VB)
unnamed: D25.1 (K), FB2.1, JP8.1 (A), Q10.3 (S)
unnamed: D26.1 (K), R74.2
unnamed: D27.1 (K), R75.2
unnamed: J1.1, U4.21 (GPIO16)
unnamed: J1.2, U4.22 (GPIO17)
unnamed: J1.3, U4.24 (GPIO18)
unnamed: J1.4, U4.25 (GPIO19)
unnamed: J1.5, U4.26 (GPIO20)
unnamed: J1.6, U4.27 (GPIO21)
unnamed: J8.1, U4.17 (GPIO13)
unnamed: J8.2, U4.16 (GPIO12)
unnamed: J8.3, U4.15 (GPIO11)
unnamed: J8.4, U4.14 (GPIO10)
unnamed: J8.5, U4.12 (GPIO9)
unnamed: J8.6, U4.11 (GPIO8)
unnamed: C37.2, J9.1, R97.2, R98.1, RV11.2, U7.2 (-)
unnamed: J21.1, R65.1, RV14.3
unnamed: J21.2, R23.1, RV12.3
unnamed: J21.3, R20.1, RV10.3
unnamed: J23.1, U4.40 (VBUS)
unnamed: C34.1, J26.1, J26.2, U6.3 (VO)
unnamed: J27.2, R81.1, U17.7 (A0)
unnamed: J29.2, R82.1, U17.8 (A1)
unnamed: J30.2, R83.1, U17.9 (A2)
unnamed: J31.2, R84.1, U17.10 (A3)
unnamed: J32.2, R86.1, U18.10 (A3)
unnamed: J33.2, R85.1, U18.9 (A2)
unnamed: J34.2, R87.1, U18.7 (A0)
unnamed: J35.2, R88.1, U18.8 (A1)
unnamed: J36.2, R90.1, U19.10 (A3)
unnamed: J37.2, R89.1, U19.9 (A2)
unnamed: J38.2, R91.1, U19.7 (A0)
unnamed: J39.2, R92.1, U19.8 (A1)
unnamed: J40.2, R94.1, U20.10 (A3)
unnamed: J41.2, R93.1, U20.9 (A2)
unnamed: J42.2, R95.1, U20.7 (A0)
unnamed: J43.2, R96.1, U20.8 (A1)
unnamed: J44.1, U4.29 (GPIO22)
unnamed: C13.2, J45.2, J46.1, R35.1
unnamed: C14.1, J47.2, J48.1, R36.2
unnamed: C19.2, J49.2, J50.1, R43.1
unnamed: C24.2, J51.2, J52.1, R51.1
unnamed: C29.2, J53.2, J54.1, R63.1
unnamed: C10.2, J55.2, J56.1, R59.1
unnamed: C27.2, J57.2, J58.1, R61.1
unnamed: C20.1, J59.2, J60.1, R44.2
unnamed: C25.1, J61.2, J62.1, R52.2
unnamed: C28.1, J63.2, J64.1, R62.2
unnamed: C26.1, J65.2, J66.1, R60.2
unnamed: C30.1, J67.2, J68.1, R64.2
unnamed: J69.1, U16.40 (VBUS)
unnamed: J70.1, R19.1
unnamed: C36.2, J71.2, R20.2, R21.1, RV10.2, U7.3 (+)
unnamed: C39.2, J77.2, R23.2, R25.1, RV12.2, U7.5 (+)
unnamed: C38.2, J78.1, R24.2, R26.1, RV13.2, U7.6 (-)
unnamed: C41.2, J83.2, R65.2, R67.1, RV14.2, U8.3 (+)
unnamed: C40.2, J84.1, R66.2, R68.1, RV15.2, U8.2 (-)
unnamed: J85.1, R80.1, RV8.3
unnamed: J85.2, R72.1, RV6.3
unnamed: J85.3, R71.1, RV4.3
unnamed: C44.2, J98.2, R71.2, R101.1, RV4.2, U9.5 (+)
unnamed: C42.2, J99.1, R73.2, R103.1, RV5.2, U9.6 (-)
unnamed: C46.2, J100.2, R72.2, R102.1, RV6.2, U9.3 (+)
unnamed: C43.2, J101.1, R79.2, R105.1, RV7.2, U9.2 (-)
unnamed: C47.2, J102.2, R80.2, R104.1, RV8.2, U8.5 (+)
unnamed: C45.2, J103.1, R100.2, R106.1, RV9.2, U8.6 (-)
unnamed: Q1.1 (B), R7.2
unnamed: Q1.2 (E), R56.1
unnamed: Q2.1 (B), R8.2
unnamed: Q2.2 (E), R57.1
unnamed: Q3.1 (B), R9.2
unnamed: Q3.2 (E), R58.1
unnamed: C35.2, Q10.1 (G), R19.2
unnamed: Q13.1 (B), R33.2
unnamed: Q13.2 (E), R34.1
unnamed: Q16.1 (B), R39.2
unnamed: Q16.2 (E), R42.1
unnamed: Q19.1 (B), R47.2
unnamed: Q19.2 (E), R50.1
unnamed: R22.1, R99.1, U7.1
unnamed: R27.1, R28.1, U7.7
unnamed: R69.1, R70.1, U8.1
unnamed: R107.1, R109.1, U9.7
unnamed: R108.1, R111.1, U9.1
unnamed: R110.1, R112.1, U8.7
Potentiometer 1: RV1.2, U4.31 (GPIO26_ADC0)
Potentiometer 2: RV2.2, U4.32 (GPIO27_ADC1)
Potentiometer 3: RV3.2, U4.34 (GPIO28_ADC2)
SCL: U16.2 (GPIO1), U17.3 (SCL), U17.5 (ADDR), U18.3 (SCL), U19.3 (SCL), U20.3 (SCL)
SDA: U16.1 (GPIO0), U17.4 (SDA), U18.4 (SDA), U18.5 (ADDR), U19.4 (SDA), U20.4 (SDA)
Sensor 1A: J7.1, R22.2
Sensor 1B: J7.2, R28.2
Sensor 1C: J7.3, R70.2
Sensor 2A: J7.4, R109.2
Sensor 2B: J7.5, R111.2
Sensor 2C: J7.6, R112.2
VDD: R81.2, R82.2, R83.2, R84.2, R85.2, R86.2, R87.2, R88.2, R89.2, R90.2, R91.2, R92.2, R93.2, R94.2, R95.2, R96.2, U16.36 (3V3), U17.1 (VDD), U18.1 (VDD), U19.1 (VDD), U19.5 (ADDR), U20.1 (VDD)
VPP: C10.1, C13.1, C19.1, C24.1, C27.1, C29.1, C48.1, C49.1, C50.1, C51.1, C52.1, C53.1, J45.1, J49.1, J51.1, J53.1, J55.1, J57.1, Q4.2 (D), Q6.2 (D), Q8.2 (D), Q14.2 (D), Q17.2 (D), Q20.2 (D), R24.1, R66.1, R73.1, R79.1, R97.1, R100.1, R117.1, RV5.1, RV7.1, RV9.1, RV11.1, RV13.1, RV15.1
VSS: J6.1, R115.1, R116.1
VSSA: C31.1, C33.1, C35.1, JP9.1 (A), Q10.2 (D), R115.2, R116.2, U5.1 (VI), U6.1 (VI)
Vdrive: FB2.2, JP8.2 (B), JP9.2 (B), R117.2

Notes on the sheet:
Raspberry Pi Pico
Power Control
Temperature Sensor
Buttons
Sensing Circuit
Motor 2
* Indicates a PWM-capable pin
Hall sensors
Motor 1

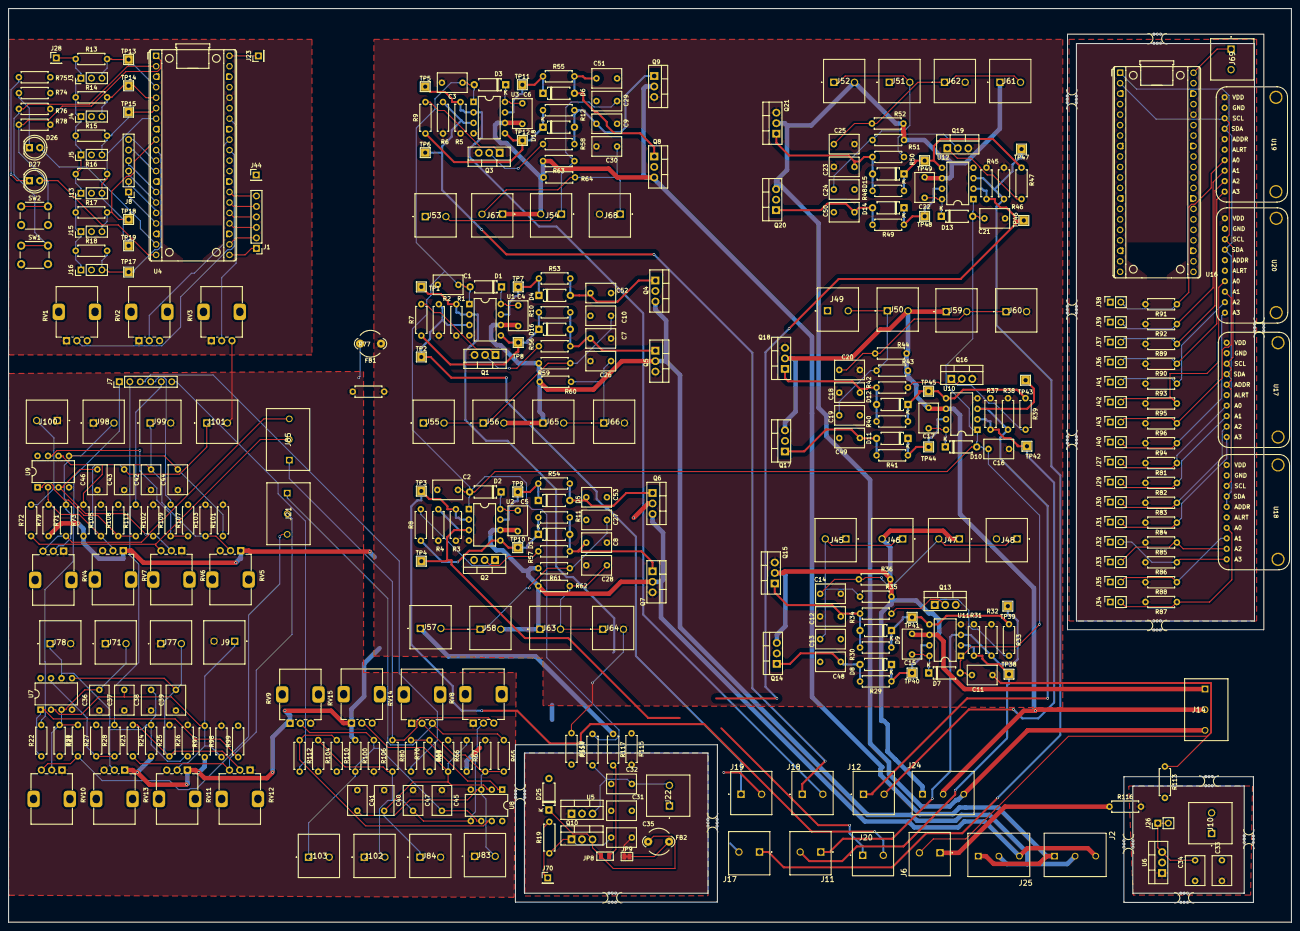
[picture p18: board PCB.kicad_pcb from above]

Board: 2 copper layers, 311.0 x 221.5 mm, 374 parts (0 on the bottom side), 168 nets.

Other parts of the board:
mouse-bite-2.54mm-slot, mouse-bite-2.54mm-slot2, mouse-bite-2.54mm-slot3, mouse-bite-2.54mm-slot4, mouse-bite-2.54mm-slot4#2, mouse-bite-2.54mm-slot4#3, mouse-bite-2.54mm-slot5, mouse-bite-2.54mm-slot7, mouse-bite-2.54mm-slot8, mouse-bite-2.54mm-slot8#2, mouse-bite-2.54mm-slot8#3, mouse-bite-2.54mm-slot8#4, mouse-bite-2.54mm-slot9: VAL**; mouse-bite-2.54mm-slot
