rhysyim/Electronic-Speed-Controller/(commit log)

2023-12-26 Add ESC v5
2024-10-21 Update ESC code for PCB layout with Pi Pico
2024-11-02 Update PWM for phase 2
2024-11-29 Add PCB schematics v3
    [PCB-B_Cu.gbr, PCB-B_Mask.gbr, PCB-B_Paste.gbr, PCB-B_Silkscreen.gbr, PCB-Edge_Cuts.gbr, PCB-F_Cu.gbr, PCB-F_Mask.gbr, PCB-F_Paste.gbr]
2024-11-30 Update code for ESC
    [FFT.csv]
2024-12-07 Add tracks for PCB
    [PCB.kicad_pcb, PCB.kicad_sch]
2024-12-10 Add trapezoidal code for ESC
2024-12-15 Update code to use PWM slice
2024-12-15 Update PCB
    [PCB.kicad_pcb, PCB.kicad_sch]
2024-12-16 Slightly optimize PCB tracks
    [PCB.dsn, PCB.kicad_pcb]
2025-01-19 Fix potentiometer footprint and overlapping silkscreen on PCB
    [PCB.kicad_pcb, PCB.kicad_sch]
2025-02-16 Update Gerber files
    [PCB-B_Cu.gbr, PCB-B_Mask.gbr, PCB-B_Paste.gbr, PCB-B_Silkscreen.gbr, PCB-Edge_Cuts.gbr, PCB-F_Cu.gbr, PCB-F_Mask.gbr, PCB-F_Paste.gbr]
2025-03-29 Add PCB, Schematics
2025-11-10 Add ESC Issues Writeup
2025-11-23 Upload updated code
    [Back EMf.csv, Comparator.csv, FFT.csv, Gate driver output.csv, Motor output (without turning).csv, PWM With Power Supply.csv, PWM Without Power Supply.csv, PWM output from pi pico.csv]
2025-11-23 Add notes on PWM frequency and control issues
    Document issues with PWM frequency and control modes.
2025-12-31 Add thermistor code
2025-12-31 Refactor temperature monitoring code for ADS1015
2026-02-05 Refactor thermistor instrumentation code
2026-02-05 Add code to scan for I2C on the port
2026-04-09 New version of PCB included, with more spacing between MOSFETs
    [PCB-B_Cu.gbr, PCB-B_Mask.gbr, PCB-B_Paste.gbr, PCB-B_Silkscreen.gbr, PCB-Edge_Cuts.gbr, PCB-F_Cu.gbr, PCB-F_Mask.gbr, PCB-F_Paste.gbr]
2026-04-09 Revise README with hardware implementation details
    Updated the README to reflect hardware implementation details and changes in PCB versions.
2026-04-09 Remove unused gerber files
    [PCB-B_Cu.gbr, PCB-B_Mask.gbr, PCB-B_Paste.gbr, PCB-B_Silkscreen.gbr, PCB-Edge_Cuts.gbr, PCB-F_Cu.gbr, PCB-F_Mask.gbr, PCB-F_Paste.gbr]
2026-04-15 Add datasheets for components used
    [PCB.kicad_sch]
2026-04-26 Update I2C SDA/SCL pins and improve ADC readings
